SethNeumann/MRCS-Tortoise-to-MP-Adapter/README.md

# REPO NAME: MRCS-Tortoise-to-MP-Adapter

## License: Creative Commons Attribution-NonCommercial-ShareAlike

relay driven by a low power tortoise drive circuit (usually an LM324). Relay operates and switches 12V to MP Motor
eventually will have a 3.5mm phoenix plug for MP10
