SethNeumann/MRCS-Tortoise-to-MP-Adapter/MRCS-Tortoise-to-MP-Adapter.brd

## EAGLE design MRCS-Tortoise-to-MP-Adapter.brd (2023-06-29)

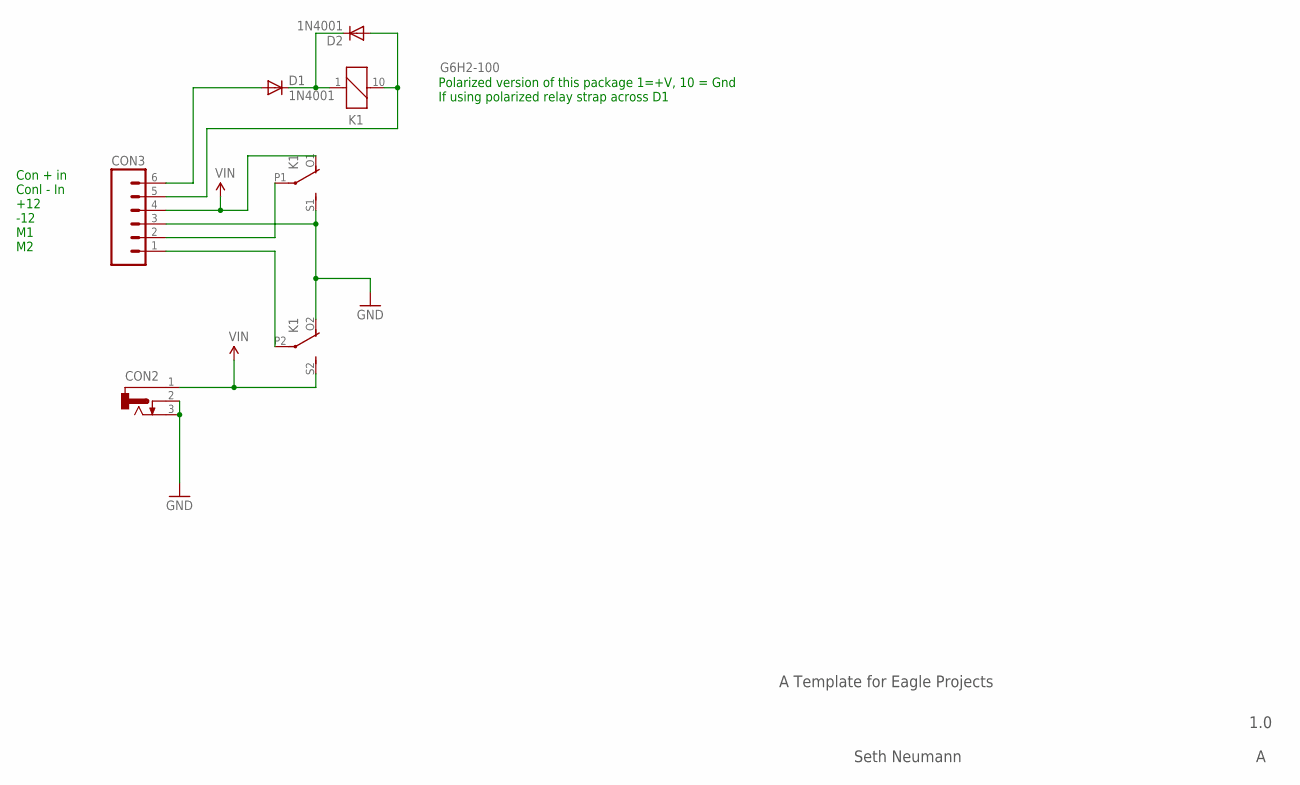
[picture p1: schematic MRCS-Tortoise-to-MP-Adapter.sch]

Parts:
CON2: CONNECTOR-DC-POWER-RA; DCJ0202
CON3: CONNECTOR-M063.5MM-6; SCREWTERMINAL-3.5MM-6
D1, D2: 1N4001; DIODE-1N4001
K1: G6H2-100

Connections:
GND: CON2.2, CON2.3, CON3.3, K1.O2 (O), K1.S1 (S)
unnamed: CON3.6, D1.A
unnamed: D1.C, D2.C, K1.1
unnamed: CON3.5, D2.A, K1.10 (2)
unnamed: CON3.2, K1.P1
unnamed: CON3.1, K1.P2
VIN: CON2.1, CON3.4, K1.O1 (O), K1.S2 (S)

Notes on the sheet:
A Template for Eagle Projects
1.0
Seth Neumann
Polarized version of this package 1=+V, 10 = Gnd If using polarized relay strap across D1
Con + in Conl - In +12 -12 M1 M2

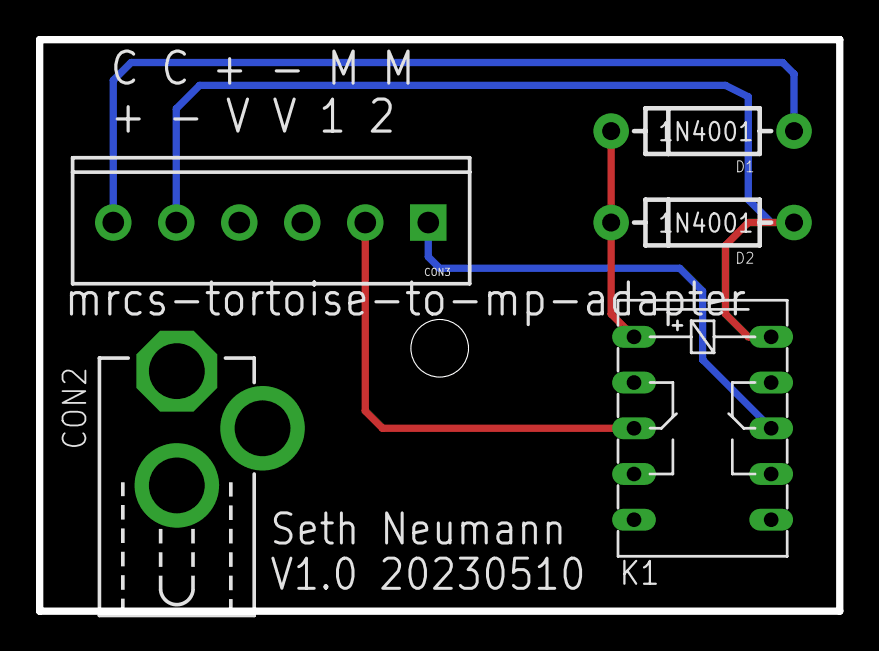
[picture p2: board MRCS-Tortoise-to-MP-Adapter.brd from above]

Board: 2 copper layers, 44.5 x 31.8 mm, 8 parts (0 on the bottom side), 7 nets.

Other parts of the board:
U$1: MRCSLOGOTOP
U$2: CA-PROP65WARNING
U$3: MRCSLOGOBTM
