SethNeumann/MRCS-Tortoise-to-MP-Adapter/MRCS-Tortoise-to-MP-Adapter-array.brd

## EAGLE design MRCS-Tortoise-to-MP-Adapter-array.brd (2023-06-29)

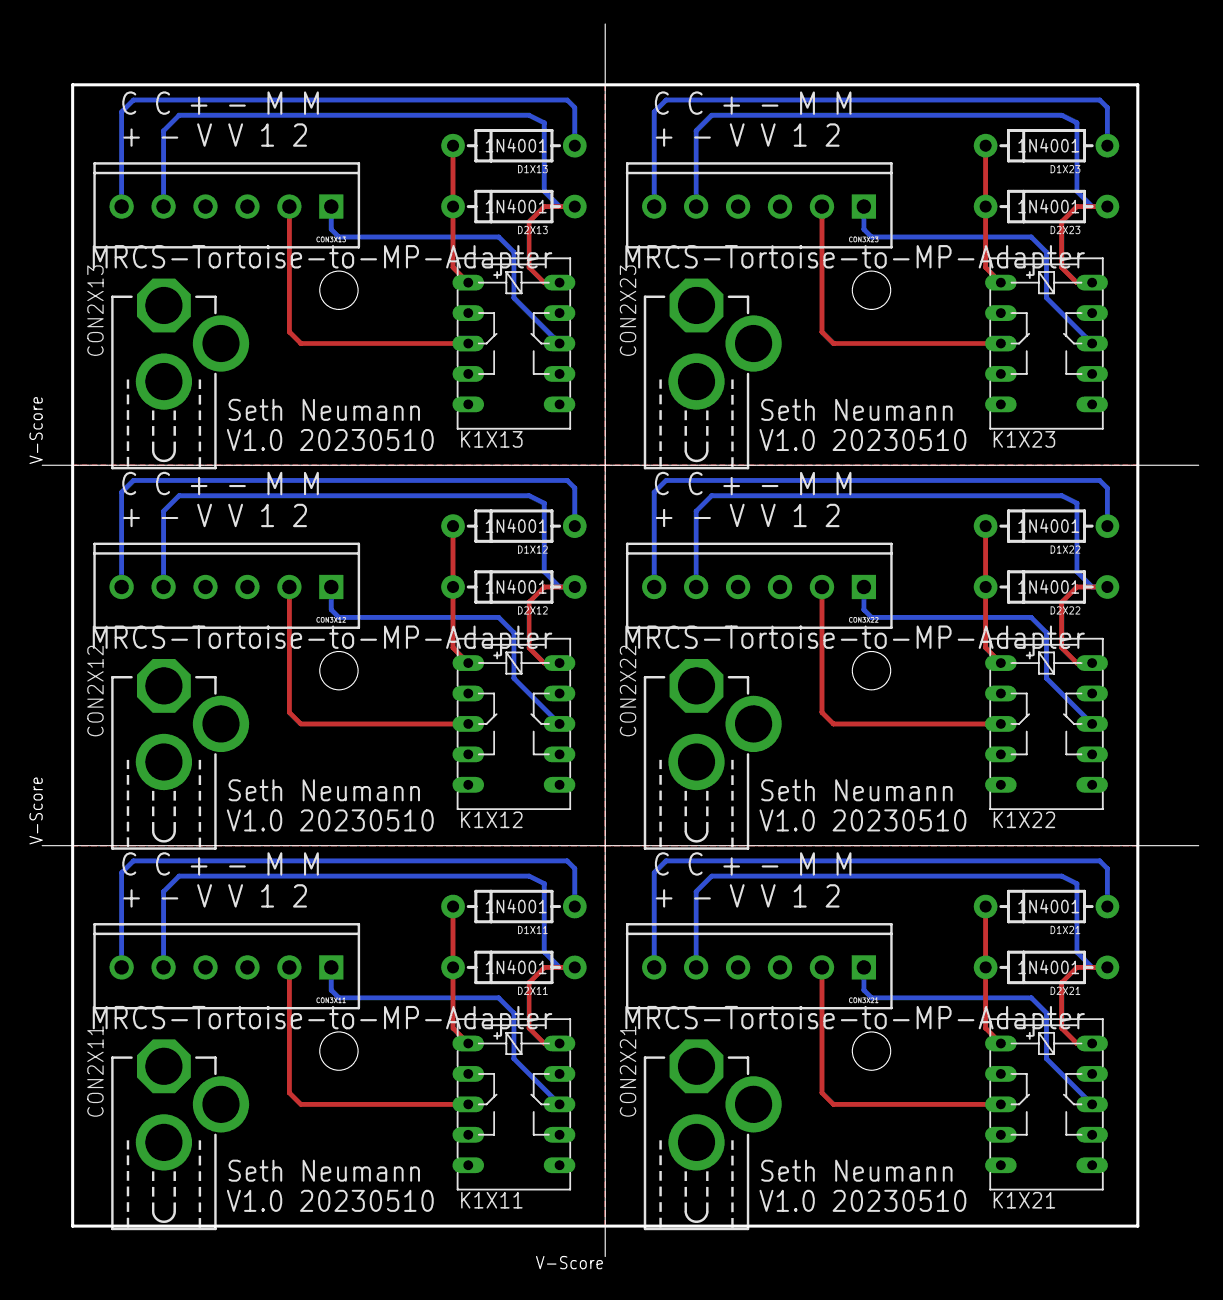
[picture p3: board MRCS-Tortoise-to-MP-Adapter-array.brd from above]

Board: 2 copper layers, 96.5 x 102.9 mm, 48 parts (0 on the bottom side), 42 nets.

Parts:
CON2X11, CON2X12, CON2X13, CON2X21, CON2X22, CON2X23: DCJ0202
CON3X11, CON3X12, CON3X13, CON3X21, CON3X22, CON3X23: SCREWTERMINAL-3.5MM-6
D1X11, D1X12, D1X13, D1X21, D1X22, D1X23, D2X11, D2X12, D2X13, D2X21, D2X22, D2X23: 1N4001; DIODE-1N4001
K1X11, K1X12, K1X13, K1X21, K1X22, K1X23: G6H2-100
U$1X11, U$1X12, U$1X13, U$1X21, U$1X22, U$1X23: MRCSLOGOTOP
U$2X11, U$2X12, U$2X13, U$2X21, U$2X22, U$2X23: CA-PROP65WARNING
U$3X11, U$3X12, U$3X13, U$3X21, U$3X22, U$3X23: MRCSLOGOBTM

Connections:
GNDX11: CON2X11.2, CON2X11.3, CON3X11.3, K1X11.O2, K1X11.S1
GNDX12: CON2X12.2, CON2X12.3, CON3X12.3, K1X12.O2, K1X12.S1
GNDX13: CON2X13.2, CON2X13.3, CON3X13.3, K1X13.O2, K1X13.S1
GNDX21: CON2X21.2, CON2X21.3, CON3X21.3, K1X21.O2, K1X21.S1
GNDX22: CON2X22.2, CON2X22.3, CON3X22.3, K1X22.O2, K1X22.S1
GNDX23: CON2X23.2, CON2X23.3, CON3X23.3, K1X23.O2, K1X23.S1
unnamed: CON3X11.6, D1X11.A
unnamed: CON3X12.6, D1X12.A
unnamed: CON3X13.6, D1X13.A
unnamed: CON3X21.6, D1X21.A
unnamed: CON3X22.6, D1X22.A
unnamed: CON3X23.6, D1X23.A
unnamed: D1X11.C, D2X11.C, K1X11.1
unnamed: D1X12.C, D2X12.C, K1X12.1
unnamed: D1X13.C, D2X13.C, K1X13.1
unnamed: D1X21.C, D2X21.C, K1X21.1
unnamed: D1X22.C, D2X22.C, K1X22.1
unnamed: D1X23.C, D2X23.C, K1X23.1
unnamed: CON3X11.5, D2X11.A, K1X11.10
unnamed: CON3X12.5, D2X12.A, K1X12.10
unnamed: CON3X13.5, D2X13.A, K1X13.10
unnamed: CON3X21.5, D2X21.A, K1X21.10
unnamed: CON3X22.5, D2X22.A, K1X22.10
unnamed: CON3X23.5, D2X23.A, K1X23.10
unnamed: CON3X11.2, K1X11.P1
unnamed: CON3X12.2, K1X12.P1
unnamed: CON3X13.2, K1X13.P1
unnamed: CON3X21.2, K1X21.P1
unnamed: CON3X22.2, K1X22.P1
unnamed: CON3X23.2, K1X23.P1
unnamed: CON3X11.1, K1X11.P2
unnamed: CON3X12.1, K1X12.P2
unnamed: CON3X13.1, K1X13.P2
unnamed: CON3X21.1, K1X21.P2
unnamed: CON3X22.1, K1X22.P2
unnamed: CON3X23.1, K1X23.P2
VINX11: CON2X11.1, CON3X11.4, K1X11.O1, K1X11.S2
VINX12: CON2X12.1, CON3X12.4, K1X12.O1, K1X12.S2
VINX13: CON2X13.1, CON3X13.4, K1X13.O1, K1X13.S2
VINX21: CON2X21.1, CON3X21.4, K1X21.O1, K1X21.S2
VINX22: CON2X22.1, CON3X22.4, K1X22.O1, K1X22.S2
VINX23: CON2X23.1, CON3X23.4, K1X23.O1, K1X23.S2
