SethNeumann/MRCS-Tortoise-to-MP-Adapter/(commit log)

2023-05-09 setting up drawing
    [MRCS-Tortoise-to-MP-Adapter.brd, MRCS-Tortoise-to-MP-Adapter.sch]
2023-05-31 clean up in preparation for panelization
    1st rev worked well and seems OK, add Prop 65 warning and minor label cleanup
    [MRCS-Tortoise-to-MP-Adapter.brd, MRCS-Tortoise-to-MP-Adapter.sch]
2023-06-01 First draft of Instructions
    this is a first pass. Eventually I'll add a list of compatible relays
2023-06-01 schematic and layout pdfs
2023-06-29 Changes to V1.1
    - Corrected minor fit issues on the SIN01 and BlackMagic librarye ntries
    - removed the F0/F1 ground jumpers on the PCR SIN-01 as it seems to want to be pulled up, but putting them up didn't change the Freq or voltage either. I left pads for F0/F1 in case SIN-01 documentation surfaces
    - changed the orientation so the break out will fit better in 7CM Tyco track (discontinued, but I have a stash)
    - simplified routing where possible.
    [MRCS-Tortoise-to-MP-Adapter-array.brd, MRCS-Tortoise-to-MP-Adapter.brd]
